alepnm/BonNanas/software/algorythm.jpg

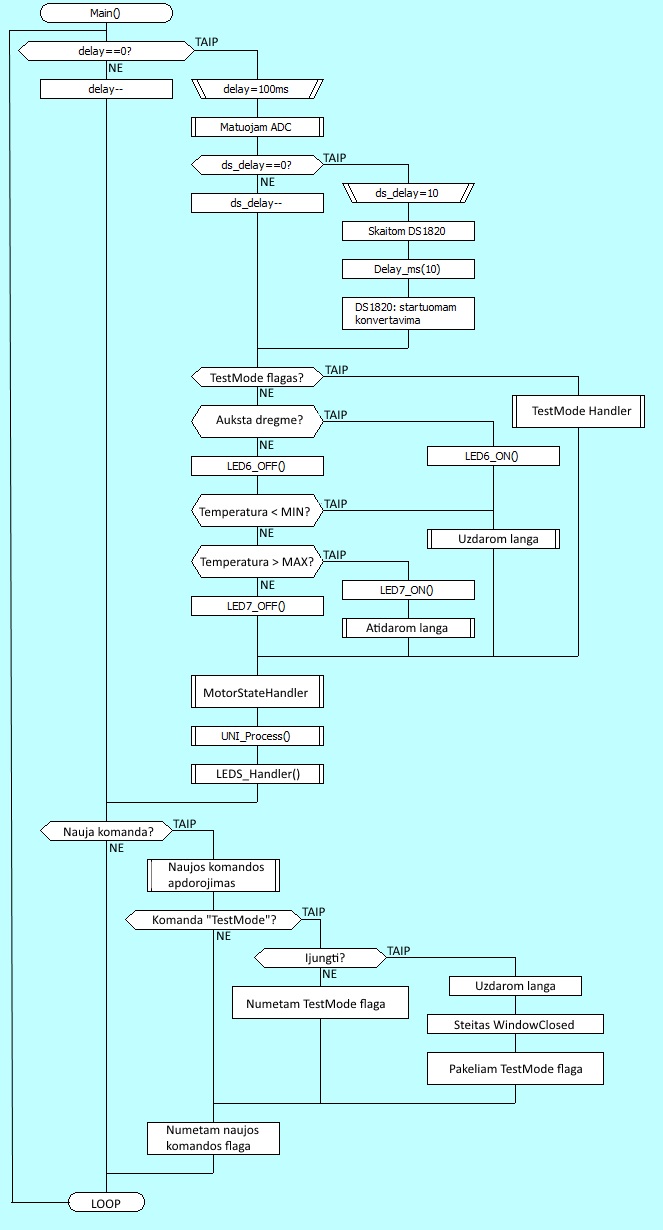
software/algorythm.jpg
