alepnm/BonNanas/hardware/valdiklis.kicad_pcb

## KiCad design hardware/valdiklis.kicad_pcb (2020-06-02)

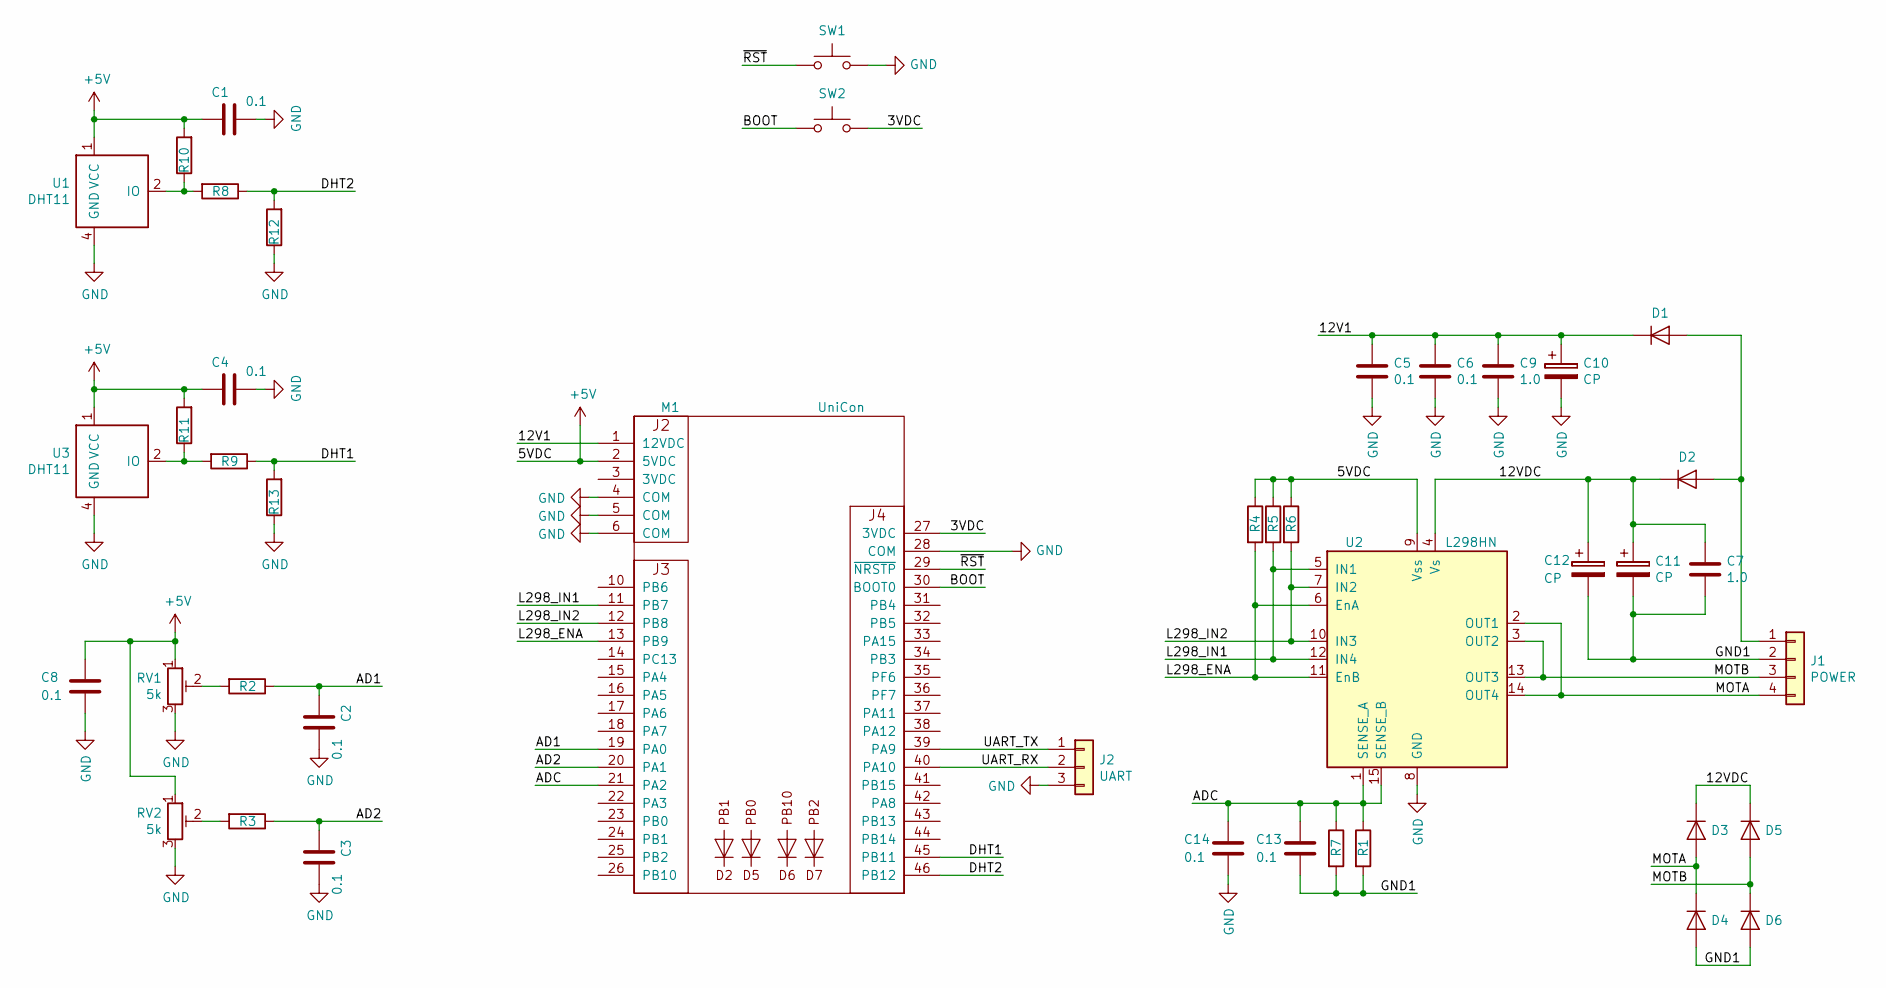
[picture p2: schematic valdiklis.sch]

Parts:
C1, C2, C3, C4, C8, C13, C14: 0.1; C_1206_3216Metric
C5, C6: 0.1; C_0805_2012Metric
C7, C9: 1.0; C_1206_3216Metric
C10: CP; CP_Radial_D5.0mm_P2.50mm
C11, C12: CP; CP_Radial_D10.0mm_P5.00mm
D1: D; D_MELF
D2: D; D_DO-27_P15.24mm_Horizontal
D3, D4, D5, D6: D; D_SMA
J1: POWER; PhoenixContact_MSTBA_2,5_4-G-5,08_1x04_P5.08mm_Horizontal
J2: UART; PinHeader_1x03_P2.54mm_Vertical
M1: UniCon; unicon
R1, R7: 1R0; R_Axial_DIN0207_L6.3mm_D2.5mm_P10.16mm_Horizontal
R2, R3, R4, R5, R6: 10k; R_0805_2012Metric
R8, R9: 47R; R_0805_2012Metric
R10, R11, R12, R13: 4,7k; R_0805_2012Metric
RV1, RV2: 5k; Potentiometer_Piher_PT-6-V_Vertical
SW1, SW2: RESET; SW_PUSH_6mm_H5mm
U1, U3: DHT11
U2: L298HN; TO-220-15_P2.54x2.54mm_StaggerOdd_Lead4.58mm_Vertical

Connections:
+5V: C1.2, C4.2, C8.1, M1.2 (5VDC), R4.1, R5.1, R6.1, R10.2, R11.2, RV1.1, RV2.1, U1.1 (VCC), U2.9 (Vss), U3.1 (VCC)
/3VDC: M1.27 (3VDC), SW2.2
/12V1: C5.1, C6.1, C9.1, C10.1, D1.1 (K), M1.1 (12VDC)
/12VDC: C7.1, C11.1, C12.1, D2.1 (K), D3.1 (K), D5.1 (K), U2.4 (Vs)
/AD1: C2.2, M1.19 (PA0), R2.1
/AD2: C3.2, M1.20 (PA1), R3.1
/ADC: C13.1, C14.1, M1.21 (PA2), R1.1, R7.1, U2.1 (SENSE_A), U2.15 (SENSE_B)
/BOOT: M1.30 (BOOT0), SW2.1
/DHT1: M1.45 (PB11), R9.1, R13.2
/DHT2: M1.46 (PB12), R8.1, R12.2
/GND1: C7.2, C11.2, C12.2, C13.2, D4.2 (A), D6.2 (A), J1.2, R1.2, R7.2
/L298_ENA: M1.13 (PB9), R4.2, U2.6 (EnA), U2.11 (EnB)
/L298_IN1: M1.11 (PB7), R5.2, U2.5 (IN1), U2.12 (IN4)
/L298_IN2: M1.12 (PB8), R6.2, U2.7 (IN2), U2.10 (IN3)
/MOTA: D3.2 (A), D4.1 (K), J1.4, U2.2 (OUT1), U2.14 (OUT4)
/MOTB: D5.2 (A), D6.1 (K), J1.3, U2.3 (OUT2), U2.13 (OUT3)
/UART_RX: J2.2, M1.40 (PA10)
/UART_TX: J2.1, M1.39 (PA9)
/~RST: M1.29 (~NRSTP), SW1.1
GND: C1.1, C2.1, C3.1, C4.1, C5.2, C6.2, C8.2, C9.2, C10.2, C14.2, J2.3, M1.4 (COM), M1.5 (COM), M1.6 (COM), M1.28 (COM), R12.1, R13.1, RV1.3, RV2.3, SW1.2, U1.4 (GND), U2.8 (GND), U3.4 (GND)
unnamed: D1.2 (A), D2.2 (A), J1.1
unnamed: R2.2, RV1.2
unnamed: R3.2, RV2.2
unnamed: R8.2, R10.1, U1.2 (IO)
unnamed: R9.2, R11.1, U3.2 (IO)

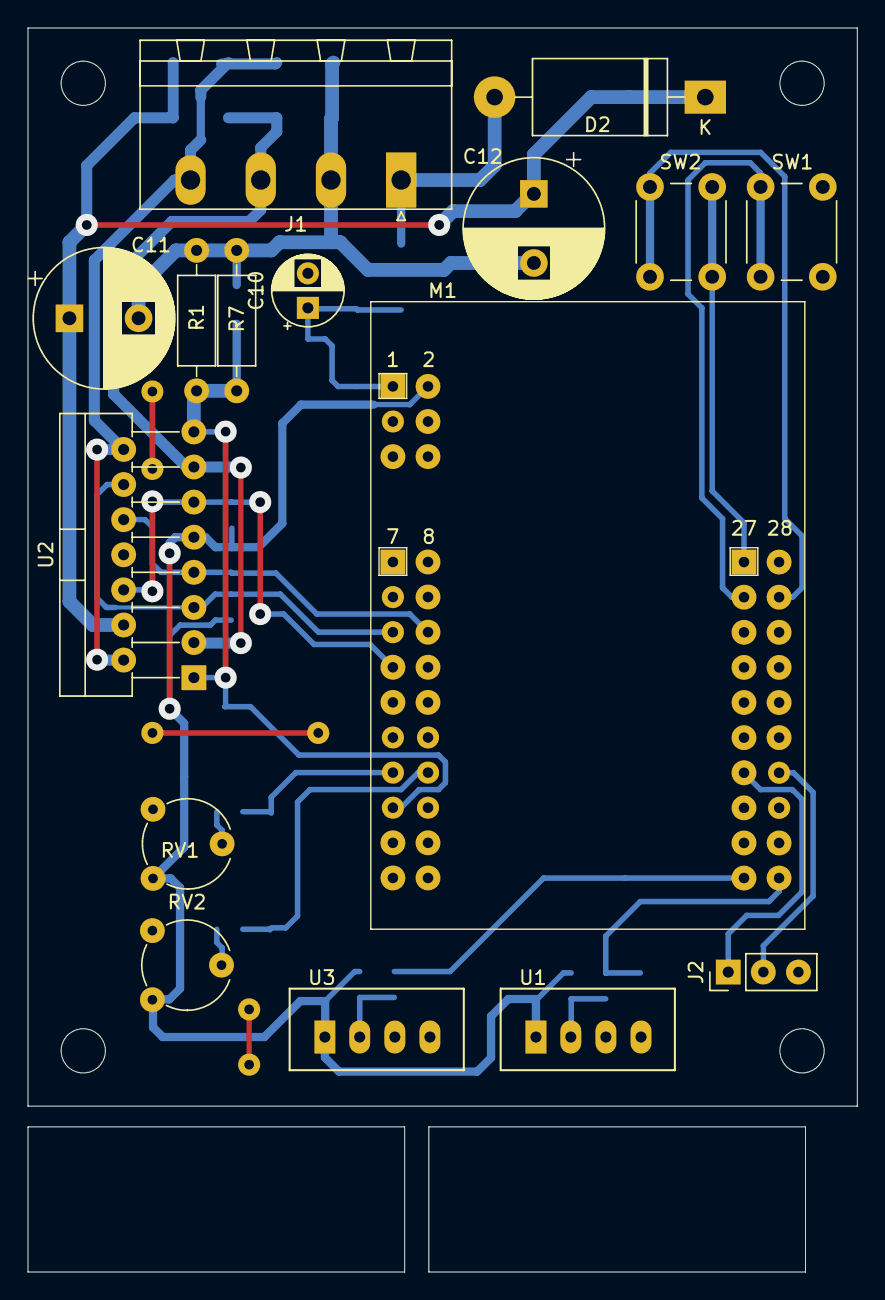
[picture p3: board valdiklis.kicad_pcb from above]

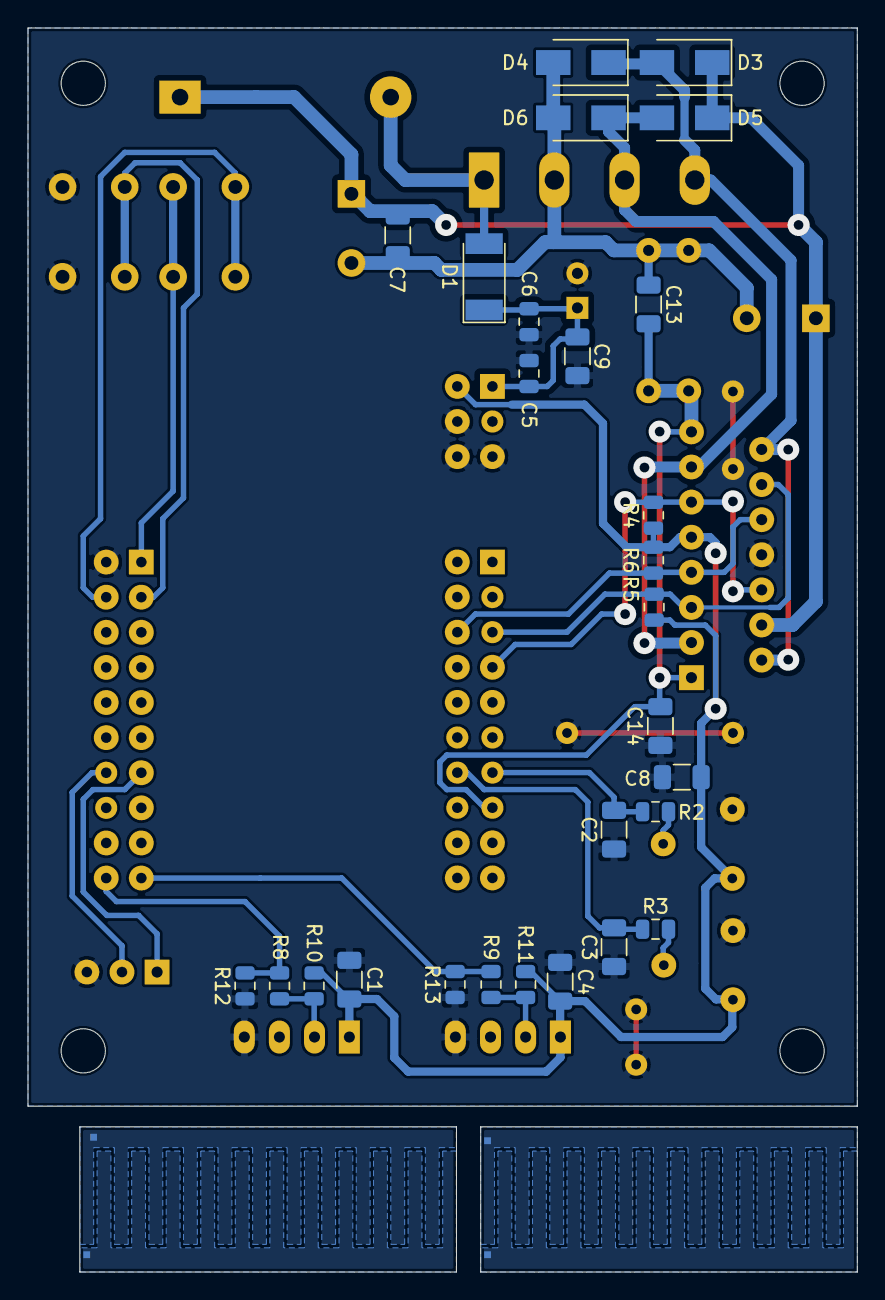
[picture p4: board valdiklis.kicad_pcb from below]

Board: 2 copper layers, 60.0 x 78.0 mm, 43 parts (27 on the bottom side), 25 nets.
