alepnm/BonNanas/software/Core/Src/main.c

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

/* Includes ------------------------------------------------------------------*/
#include "main.h"

/* USER CODE BEGIN Includes */
#include <stdio.h>
#include "unicon.h"
#include "ds18b20.h"
#include "motor.h"
#include "command.h"
/* USER CODE END Includes */

/* USER CODE BEGIN PD */
#define CH_POT_RV1      LL_ADC_CHANNEL_0
#define CH_POT_RV2      LL_ADC_CHANNEL_1
#define CH_HUMIDITY     LL_ADC_CHANNEL_5


#define HIGH_TEMPERATURE_DEF    25
#define LOW_TEMPERATURE_DEF     20
#define HUM_LEVEL_DEF           400

/* USER CODE END PD */


/* USER CODE BEGIN PV */
const char version[] = "Ver. 1.1-20190425";
SysData_TypeDef SysData;

uint8_t ds_status;
/* USER CODE END PV */

void SystemClock_Config(void);
static void MX_GPIO_Init(void);
static void MX_ADC_Init(void);
static void MX_USART1_UART_Init(void);
static void MX_TIM16_Init(void);
/* USER CODE BEGIN PFP */

static void LedHandler(void);				// LEDu hendleris
static void TestModeHandler(SysData_TypeDef *self);	// Testinio rezimo hendleris
void SetDefaults(SysData_TypeDef *self);		// Nustatyti parametru pradines reiksmes
/* USER CODE END PFP */

/**
  * @brief  The application entry point.
  * @retval int
  */

/* pagrindine funkcija - programa prasideda cia ir eina zemyn */
int main(void) {
    /* USER CODE BEGIN 1 */
    static volatile uint32_t delay = 0;		// pagrindinio laikmacio skaitliukas - 100ms periodas
    static uint8_t ds_delay = 0;		// temperaturos matavimo skaitliukas - 1s periodas 

    /* USER CODE END 1 */

    /* MCU Configuration--------------------------------------------------------*/

    /* Reset of all peripherals, Initializes the Flash interface and the Systick. */


    LL_APB1_GRP2_EnableClock(LL_APB1_GRP2_PERIPH_SYSCFG);	// -> ijungiam GRP2 proco hardwaro taktavima
    LL_APB1_GRP1_EnableClock(LL_APB1_GRP1_PERIPH_PWR);		// -> ijungiam GRP1 proco hardwaro taktavima

    /* System interrupt init*/

    /* Configure the system clock */
    SystemClock_Config();					// -> sukonfiguruojam Sistemos taktavima

    /* USER CODE BEGIN SysInit */
    SysTick_Config(SystemCoreClock/1000);			// -> sukonfiguruojam ir ijungiam sistemini taimeri - 1ms periodas
    /* USER CODE END SysInit */

    /* Initialize all configured peripherals */
    MX_GPIO_Init();						// -> sukonfiguruojam portus ir pinus
    MX_ADC_Init();						// -> sukonfiguruojam ADC konvertoriu( Analog to Digital Convertor),
								// kad galetume nuskaityti dregmes daviklio, potenciometru reiksmes
    MX_USART1_UART_Init();					// -> sukonfiguruojam UART
    MX_TIM16_Init();						// -> sukonfiguruojam TIM16 taimeri, kad galetume keisti variklio
								// sukimosi greiti
    /* USER CODE BEGIN 2 */

    LL_mDelay(10);						// ->pauze 10ms

    SetDefaults(&SysData);					// ->nustatom pradines reiksmes

    UNI_Start();						// ->sukonfiguruojam Unicon plokste

    DS18B20_PortInit();						// ->sukonfiguruojam temperaturos daviklio porta
    ds_status = DS18B20_Init(DS_MODE_SKIP_ROM);			// ->startuojam temperaturos davikli

    DS18B20_MeasureTemperCmd(DS_MODE_SKIP_ROM, 0);		// ->paleidziam temperaturos matavima, rezultata galesim pasiimti veliau
								// ->(po ~1ms)
    Delay_ms(100);						// ->pauze 100ms


    L298_Init(&SysData);					// ->inicializuojam proco hartwara, kuris valdys variklio draiveri - 
								// ->TIM16 ir ENABLE, IN1, IN2 portus

    /* USER CODE END 2 */

    /* Infinite loop */
    /* USER CODE BEGIN WHILE */

    while (1) {							// ->pagrindinis ciklas

        if(delay <= timestamp) {				// ->pagrindinio laikmacio ciklas

            delay = timestamp + 100;

            ADC_Read_VREFINT();					// ->matuojam maitinimo itampa, kad veliau galetume perskaicuoti ADC reiksmes
								// milivoltais. Bet mes to nedarome

            SysData.ADC_Data.ch0 = ADC_ReadAnalog(CH_POT_RV1);	// -> skaitom ADC kanala CH0 (potenciometras RV1)
            Delay_ms(10);

            SysData.ADC_Data.ch1 = ADC_ReadAnalog(CH_POT_RV2);	// -> skaitom ADC kanala CH1 (potenciometras RV2)
            Delay_ms(10);

            SysData.ADC_Data.ch2 = ADC_ReadAnalog(CH_HUMIDITY);	// -> skaitom ADC kanala CH5 (dregmes daviklis)
            Delay_ms(10);

            if(ds_delay == 0) {					// ->temperaturos daviklio ciklas

                ds_delay = 10;

                DS18B20_ReadStratchpad(DS_MODE_SKIP_ROM, 0);	// -> skaitom temperaturos daviklio duomenys
                SysData.temper = DS18B20_Convert(0);		// -> konvertuojam jo duomenys i temperatura

                Delay_ms(10);
                DS18B20_MeasureTemperCmd(DS_MODE_SKIP_ROM, 0);	// -> paleidziam sekanti matavima
            } else {

                ds_delay--;					// -> mazinam temperaturos daviklio laikmacio skaitliuka
            }

            if(SysData.TestMode == 0) {					// -> jai esame normaliame rezime, vykdom darbo logika

                if(SysData.ADC_Data.ch2 >= SysData.HighHumidity) {	// jai nuskaityta dregmes daviklio reiksme didesne uz nustatyta:
                    L298_CloseWindow(&SysData);				// uzdarom langa
                    LED6_ON();						// uzdegam LED6 sviesos dioda
                } else {						// jai ne:

                    LED6_OFF();						// gesinam LED6 sviesos dioda

                    if(SysData.temper >= SysData.HighTemperature) {	// jai nuskaityta temperatura virsyja auksciausia:
                        L298_OpenWindow(&SysData);			// atidarom langa
                        LED7_ON();					// uzdegam LED7 sviesos dioda
                    } else {						// jai ne:

                        if(SysData.temper < SysData.LowTemperature) {	// jai nuskaityta temperatura mazesne uz zemiausia:
                            L298_CloseWindow(&SysData);			// uzdarom langa
                        }

                        LED7_OFF();					// gesinam LED7 svesos dioda
                    }
                }
            } else {							// jai esam Teste
                /* testas */

                TestModeHandler(&SysData);				// vykdom testa
            }

            L298_Process(&SysData);					// valdom varikli

            UNI_Process();						// valdom Unicon plokste (musu atveju nieko nedarom)

            LedHandler();						// valdom kitus sviesos diodus

        }								// pagrindinio laikmacio ciklo pabaiga


        if(NewMessageFlag) {						// jai per UARTA gavom komanda

            NewMessageHandler(&SysData);				// vykdom ja

            NewMessageFlag = false;					// numetam naujos komandos flaga
        }

        /* USER CODE END WHILE */

        /* USER CODE BEGIN 3 */


    }									// pagrindinio ciklo pabaiga - gryztam i pradzia
    /* USER CODE END 3 */
}

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
/* USER CODE BEGIN 4 */

static void LedHandler(void) {

    static uint32_t delay = 0;
    static uint8_t led = 0;

    if(delay < timestamp) {

        delay = timestamp + 100;

        if(SysData.TestMode) {

            LED2_OFF();
            LED5_OFF();
            LED6_OFF();
            LED7_OFF();

            switch(led) {
            case 0:
                LED2_ON();
                led = 1;
                break;
            case 1:
                LED5_ON();
                led = 2;
                break;
            case 2:
                LED6_ON();
                led = 3;
                break;
            case 3:
                LED7_ON();
                led = 0;
                break;
            }

        } else {

            if(SysData.WindowState) LED2_ON();
            else LED2_OFF();

            if( L298_ENA_CHECK() ) LED5_ON();
            else LED5_OFF();

        }

    }
}



/*  */
static void TestModeHandler(SysData_TypeDef *self) {





}


/*  */
void SetDefaults(SysData_TypeDef *self){

    self->HighTemperature = HIGH_TEMPERATURE_DEF;
    self->LowTemperature = LOW_TEMPERATURE_DEF;
    self->HighHumidity = HUM_LEVEL_DEF;
    self->MotorSpeed = MOTOR_SPEED_DEF;
    self->MotorRunTime = MOTOR_RUNTIME_DEF;
    self->MotorPauseTime = MOTOR_PAUSE_TIME_DEF;
}


/* USER CODE END 4 */
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
