alepnm/BonNanas/software/BonNanas.ioc

Mcu.UserName=STM32F051C8Tx
PA0.GPIO_Label=AD1
PA0.Signal=ADC_IN0
PA1.GPIO_Label=AD2
PA1.Signal=ADC_IN1
PA10.Signal=USART1_RX
PA13.Signal=SYS_SWDIO
PA14.Signal=SYS_SWCLK
PA2.GPIO_Label=ADC
PA2.Signal=ADC_IN2
PA5.GPIO_Label=HUMIDITY
PA5.Signal=ADC_IN5
PA9.Signal=USART1_TX
PB0.GPIO_Label=LED5
PB0.Signal=GPIO_Output
PB1.GPIO_Label=LED2
PB1.Signal=GPIO_Output
PB10.GPIO_Label=LED6
PB10.Signal=GPIO_Output
PB11.Signal=GPIO_Analog
PB12.Signal=GPIO_Output
PB2.GPIO_Label=LED7
PB2.Signal=GPIO_Output
PB7.GPIO_Label=L298_IN1
PB7.Signal=GPIO_Output
PB8.GPIO_Label=L298_IN2
PB8.Signal=S_TIM16_CH1
PB9.GPIO_Label=L298_ENA
PB9.Signal=GPIO_Output
