alepnm/BonNanas/(commit log)

2019-04-14 repo inicializavimas
    [valdiklis.kicad_pcb, valdiklis.sch]
2019-04-15 pcb plokstes ir schemos paruosimas
    [valdiklis.kicad_pcb, valdiklis.sch]
2019-04-15 pcb ir schemos paruosimas
    [valdiklis.kicad_pcb, valdiklis.sch]
2019-04-23 surenkti reikalingi failai
    [Kainorastis.ods, valdiklis.kicad_pcb, valdiklis.sch]
2020-06-02 surasyti kommentai
    [valdiklis.kicad_pcb]
