alepnm/BonNanas/(notices)

Notices in the files:
software/Core/Src/main.c:
COPYRIGHT(c) 2019 STMicroelectronics
(C) COPYRIGHT STMicroelectronics *****END OF FILE
